altaga/EHM--Advanced-Wearables/IMG/proj.png

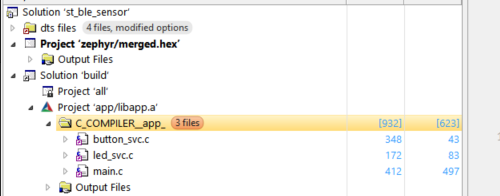
IMG/proj.png
