altaga/EHM--Advanced-Wearables/nRF Project/build_nrf5340dk_nrf5340_cpuapp/zephyr_settings.txt

"BOARD_ROOT":"C:/Users/VAI/ncs/v1.5.1/nrf"
"DTS_ROOT":"C:/Users/VAI/ncs/v1.5.1/nrf"
"MODULE_EXT_ROOT":"C:/Users/VAI/ncs/v1.5.1/nrf"
